TaylorSharpeSS/CEAQL_Air_Quality_Lamp/README.md

# CEAQL_Air_Quality_Lamp
Firmware, EAGLE files and instructions for producing and assembling the Collaboratively Engineered Air Quality Lamp - A project developed by Autodesk and SweetSense
