TaylorSharpeSS/CEAQL_Air_Quality_Lamp/CEAQL BOM.xlsx

CEAQL (Collaboratively Engineered Air Quality Lamp) PCB BOM
Internal Part # | Description | Count | Manuf. Part Number | URL | Ordered | Notes | Price for One | Price for Five
HW-001 | Honeywell PM2.5 Sensor | 1 | HPMA115S0-XXX | https://www.mouser.com/ProductDetail/785-HPMA115SO-XXX | FALSE |  | $32.96 | $139.30
HW-002 | Adafruit ItsyBitsy 32u4 3V | 1 | 3675 | https://www.mouser.com/ProductDetail/485-3675 | FALSE | Make sure to use the 3V version, not the 5V version! | $9.95 | $49.75
HW-003 | Molex Cable for Sensor | 1 | 15134-0802 | https://www.mouser.com/ProductDetail/538-15134-0802 | FALSE | 50mm long, plugs into PIN-008 | $5.34 | $25.65
HW-004 | Pololu 5V Boost Converter | 1 | U1V11F5 | https://www.pololu.com/product/2562 | FALSE | Required because the Honeywell sensor needs 5V power, but uses 3.3V logic | $4.95 | $21.25
HW-005 | Adafruit LiPo/Lion Backpack | 1 | 2124 | https://www.mouser.com/ProductDetail/Adafruit/2124 | FALSE | Extra work: cut power switch trace, bridge 0.5A charging pads | $4.95 | $24.75
HW-006 | 1200mAh LiPoly Battery | 1 | 258 | https://www.mouser.com/ProductDetail/Adafruit/258 | FALSE |  | $9.95 | $49.75
HW-007 | NeoPixel Ring, 24, RGB | 1 | 1586 | https://www.mouser.com/ProductDetail/Adafruit/1586?qs=sGAEpiMZZMsMyYRRhGMFNsZX0NweIHLslsanHhsaRAM%3d | FALSE |  | $16.96 | $84.80
PIN-001 | Female headers, 5-up | 1 | 929984-01-05-RK | https://www.mouser.com/ProductDetail/3M-Electronic-Solutions-Division/929984-01-05-RK | FALSE | ItsyBitsy Top Row | $1.52 | $6.85
PIN-002 | Female headers, 14-up | 2 | 929984-01-14-RK | https://www.mouser.com/ProductDetail/3M-Electronic-Solutions-Division/929984-01-14-RK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 | FALSE | ItsyBitsy Side Rows | $2.29 | $10.40
PIN-003 | Female headers, 4-up | 1 | 929984-01-04 | https://www.mouser.com/ProductDetail/3M-Electronic-Solutions-Division/929984-01-04 | FALSE | Boost Board Rail | $1.52 | $7.35
PIN-004 | Female headers, 3-up | 1 | 929870-01-03-RA | https://www.mouser.com/ProductDetail/3M-Electronic-Solutions-Division/929870-01-03-RA | FALSE | LiPo Charger Rail 1 | $0.65 | $3.00
PIN-005 | Female headers, 2-up | 1 | 929870-01-02-RB | https://www.mouser.com/ProductDetail/3M-Electronic-Solutions-Division/929870-01-02-RB | FALSE | LiPo Charger / Power Rail | $0.55 | $2.52
PIN-006a | Female tall headers, 4-up | 2 | 929974-01-04-RK | https://www.mouser.com/ProductDetail/3M-Electronic-Solutions-Division/929974-01-04-RK | FALSE | For hacker I/O pins (4 digital, 4 analog) | $1.41 | $6.40
PIN-006b | Female tall headers, 2-up | 1 | 929974-01-02-RK | https://www.mouser.com/ProductDetail/3M-Electronic-Solutions-Division/929974-01-02-RK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 | FALSE | For hacker power pins | $1.37 | $6.00
PIN-007 | Male headers, low-profile, 32-up | 1 | 350-80-164-00-019101 | https://www.mouser.com/ProductDetail/Preci-dip/350-80-164-00-019101 | FALSE | 3mm headers, 1.9mm plastic part. Only used for ItsyBitsy. | $6.25 | $29.95
PIN-008 | Molex Board-mount | 1 | 53047-0810 | https://www.mouser.com/ProductDetail/Molex/53047-0810 | FALSE | Pico-blade, 1.25mm Pitch | $0.79 | $3.23
BUT-001 | Mode Toggle Button | 1 | B3F-1000 | https://www.mouser.com/ProductDetail/Omron-Electronics/B3F-1000?qs=lK7M36XCk6JQHckSc1xIsg%3D%3D | FALSE | Momentary | $0.25 | $1.24
BUT-002 | On/Off PWR Switch | 1 | EG1218 | https://www.mouser.com/ProductDetail/E-Switch/EG1218?qs=sGAEpiMZZMtHXLepoqNyVZDOWY7elTCOE4MJ3sXRkSs%3d | FALSE | Slider | $0.67 | $3.22
SCREW-001 | Through Screws, 6-32 x 3" | 3 | 91253A168 | https://www.mcmaster.com/91253a168 | FALSE | Also available in stainless steel | $4.33 | $21.66
PCB-001 | Order through OSHPark | 1 | n/a | https://oshpark.com/shared_projects/p7LVxjU8 | FALSE | It should be possible to order sets of 3 through this link (MOQ 3) | $9.70 | $19.40
 |  |  |  |  |  |  | Total (1 unit) | Total (5)
 |  |  |  |  |  |  | $116.36 | $516.48
 |  |  |  |  |  |  |  | -> | $103.30 | each, at MOQ 5
