TaylorSharpeSS/CEAQL_Air_Quality_Lamp/MASTER CEAQL PCB.brd

## EAGLE design MASTER CEAQL PCB.brd (2019-01-07)

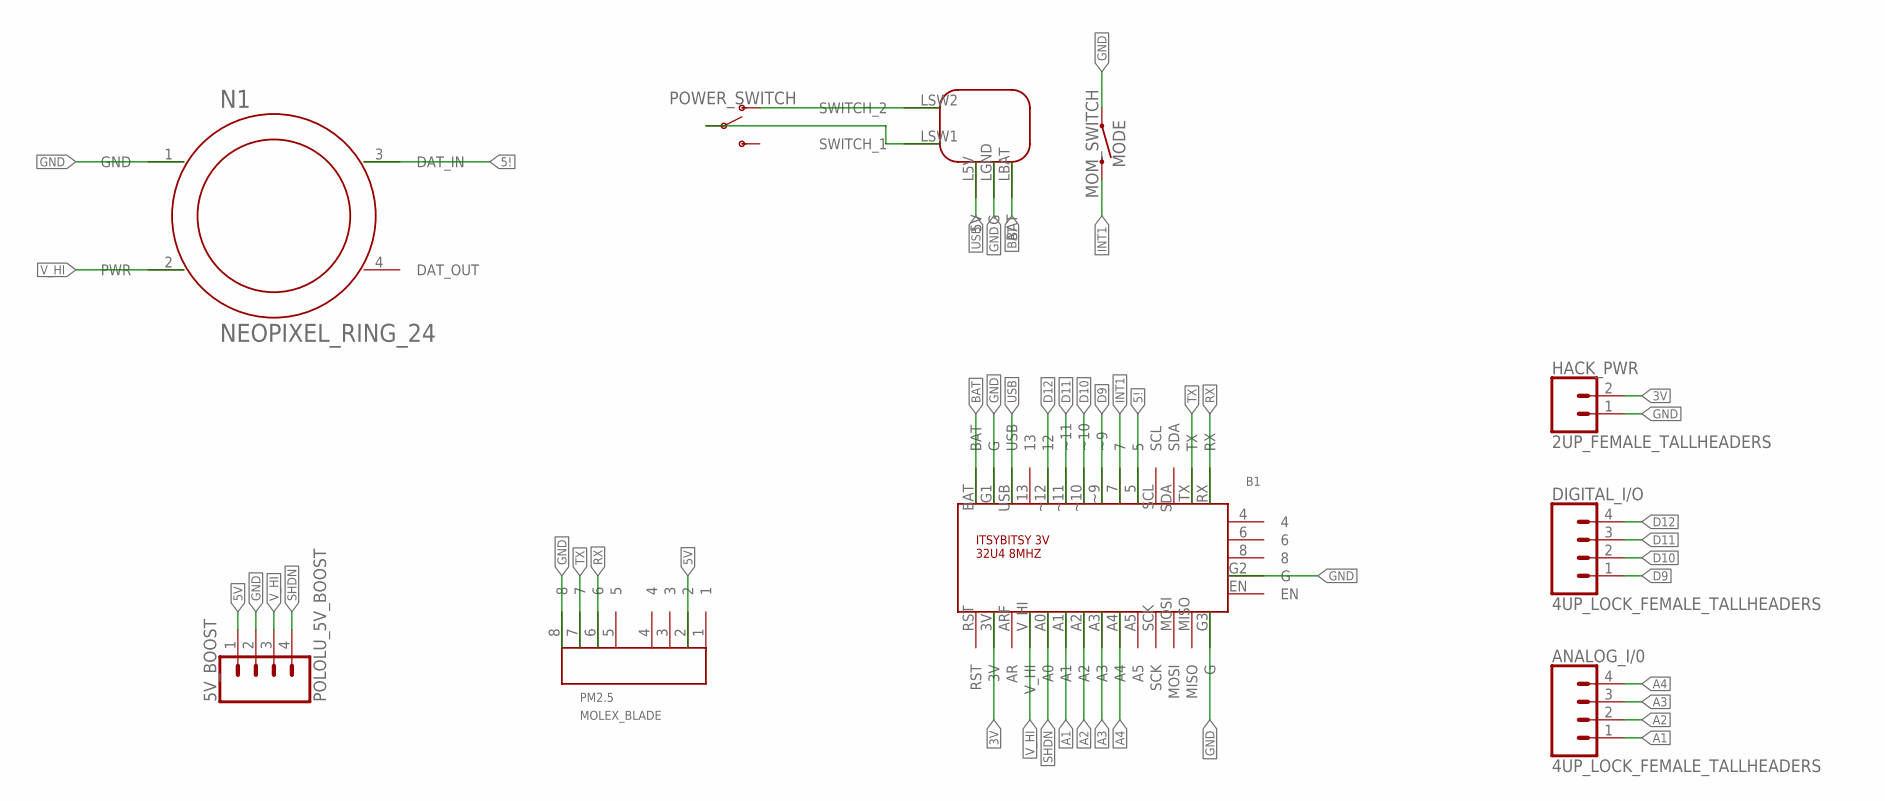
[picture p1: schematic MASTER CEAQL PCB.sch]

Parts:
5V_BOOST: POLOLU_5V_BOOST; POLOLU_5V_HEADERS
ANALOG_I/0: 4UP_LOCK_FEMALE_TALLHEADERS; 1X04_LOCK_TALL
B1: ITSY_BITSY
DIGITAL_I/O: 4UP_LOCK_FEMALE_TALLHEADERS; 1X04_LOCK_TALL
HACK_PWR: 2UP_FEMALE_TALLHEADERS; 1X02
L1: LIPOLY_CHARGER
MODE: MOM_SWITCH; TACTILE_SWITCH_PTH_6.0MM
N1: NEOPIXEL_RING_24; NEOPIXEL_RNG_24
PM2.5: MOLEX_BLADE; 53047-08
POWER_SWITCH: SWITCH_SPDT_PINMOUNT; SWITCH_SPDT_PTH_11.6X4.0MM_LOCK

Connections:
3V: B1.3V, HACK_PWR.2
5!: B1.5, N1.3 (DAT_IN)
5V: 5V_BOOST.1, PM2.5.2
A1: ANALOG_I/0.1, B1.A1
A2: ANALOG_I/0.2, B1.A2
A3: ANALOG_I/0.3, B1.A3
A4: ANALOG_I/0.4, B1.A4
BAT: B1.BAT, L1.LBAT (BAT)
D9: B1.~9, DIGITAL_I/O.1
D10: B1.~10, DIGITAL_I/O.2
D11: B1.~11, DIGITAL_I/O.3
D12: B1.~12 (12), DIGITAL_I/O.4
GND: 5V_BOOST.2, B1.G1 (G), B1.G2 (G), B1.G3 (G), HACK_PWR.1, L1.LGND (G), MODE.1, N1.1 (GND), PM2.5.8
INT1: B1.7, MODE.2
unnamed: L1.LSW2 (SWITCH_2), POWER_SWITCH.1 (O)
unnamed: L1.LSW1 (SWITCH_1), POWER_SWITCH.2
RX: B1.RX, PM2.5.6
SHDN: 5V_BOOST.4, B1.A0
TX: B1.TX, PM2.5.7
USB: B1.USB, L1.L5V (5V)
V_HI: 5V_BOOST.3, B1.V_HI, N1.2 (PWR)

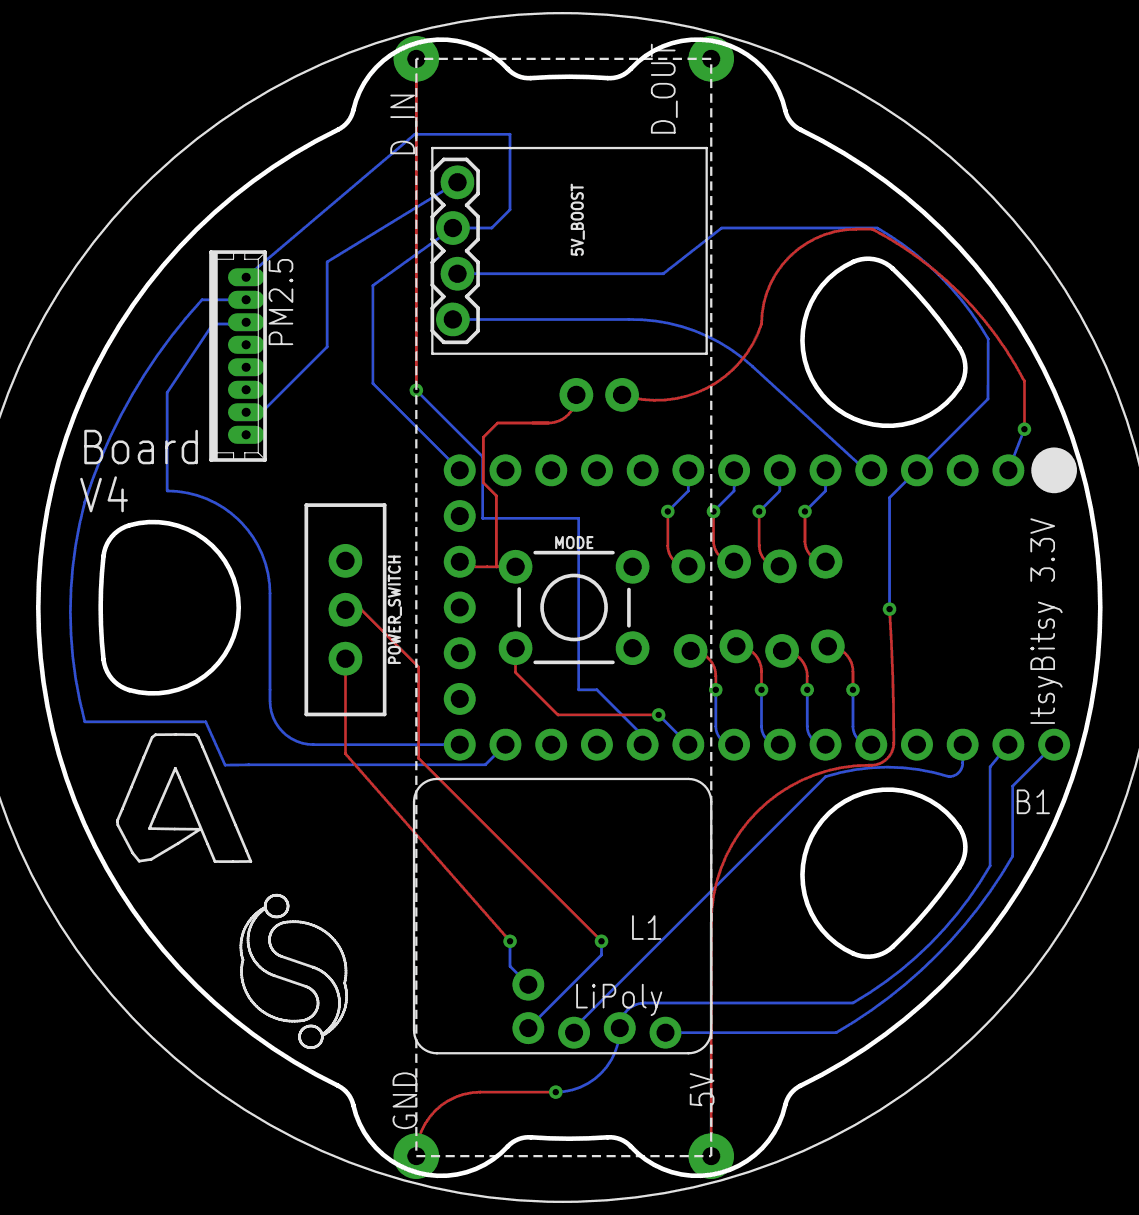
[picture p2: board MASTER CEAQL PCB.brd from above]

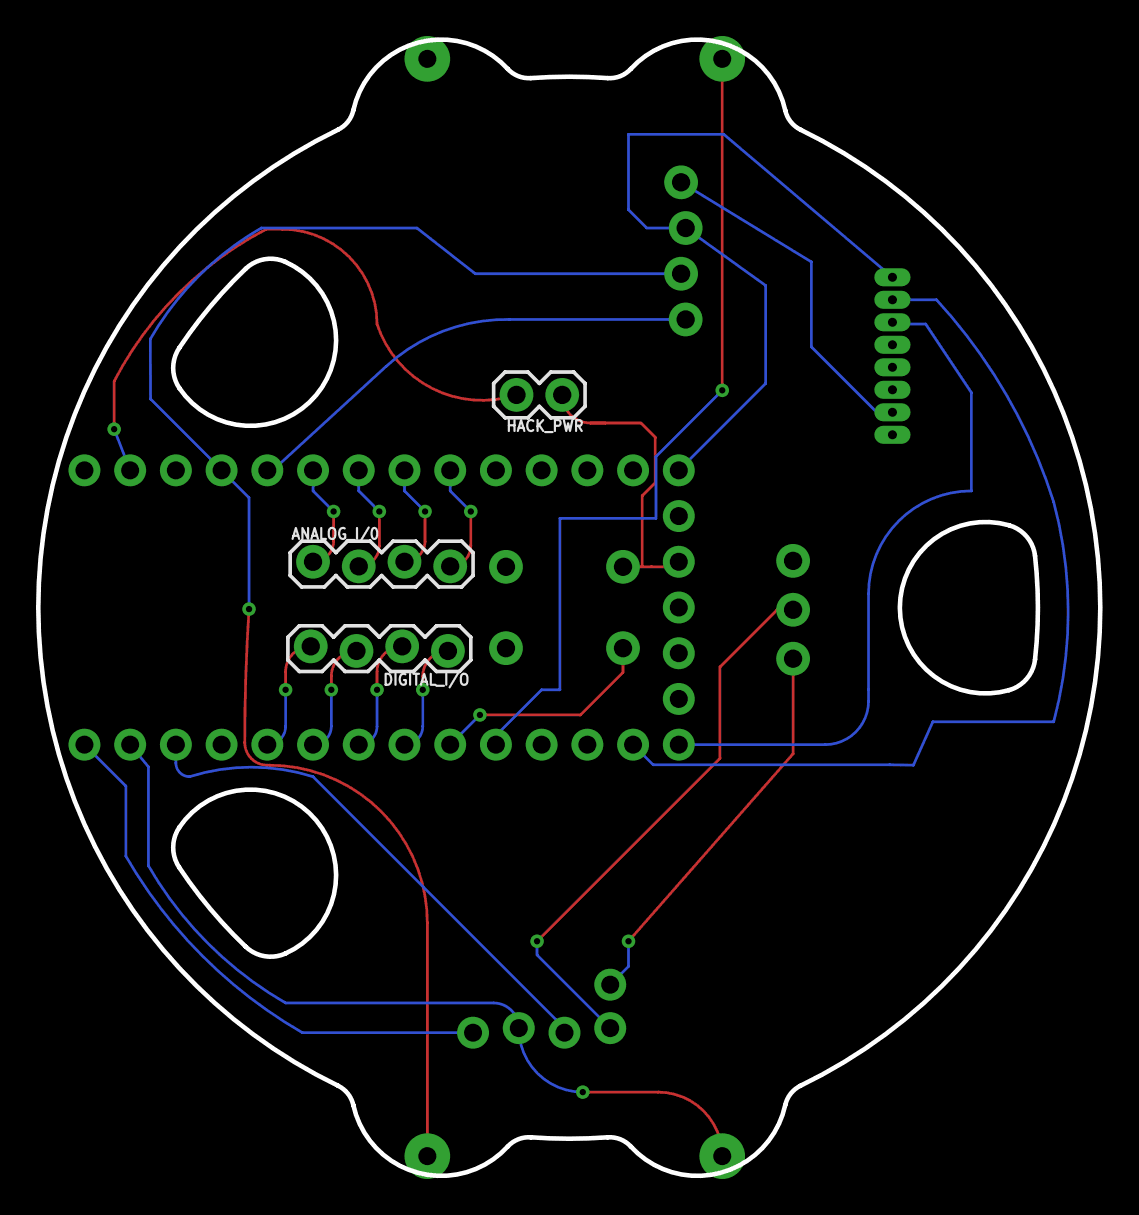
[picture p3: board MASTER CEAQL PCB.brd from below]

Board: 2 copper layers, 59.0 x 63.1 mm, 10 parts (3 on the bottom side), 21 nets.
