TaylorSharpeSS/CEAQL_Air_Quality_Lamp/(threads)

Thread 1 (2020-01-14):

Shell Overhung Lip

TaylorSharpeSS, 2020-01-14:
An overhanging lip at the top of the Shell part results in messy material that has to be cleaned up before assembly. This should be replaced with a chamfered surface that can print well without support material.
