TaylorSharpeSS/CEAQL_Air_Quality_Lamp/(commit log)

2019-01-07 Add files via upload
    To manufacture your own CEAQL, you'll need a soldering station for through-hole components.
    (1) Order parts from the CEAQL BOM. The BOM includes a link to a public PCB which can be ordered through OSH Park.
    (2) 3D print or machine the mechanical components based on the Fusion 360 design, which you can download here: https://www.autodesk.com/campaigns/concept-to-production
    (3) Follow the soldering work instructions included in this repository.
    (4) Install the modified HPMA library through the Arduino IDE. Upload the V7 firmware to your board through the Arduino IDE.
    (5) Assemble the sensor, turn it on, and test your air quality!
    More information about the health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
    [CEAQL BOM.ods, CEAQL BOM.xlsx, MASTER CEAQL PCB.brd, MASTER CEAQL PCB.sch]
2019-06-07 3D Printable CEAQL Parts
    STL files to produce the mechanical components of the CEAQL. All of these parts can be printed on a standard 3D printer without needing support material. Suggested layer height is 0.10mm.
2019-10-07 Added fasteners (6-32 x 3") to BOM
    [CEAQL BOM.xlsx]
